CyrusAlexanderBarrett-Hammer/Programmable-furnace/Quick notes.rtf

This system has an Arduino as the central controll unit, and could, in the long run, run multiple furnaces at once, but these use cases are very few.
The controller can run as a standalone, but has extended functionality when interfaced with an interface like a computer.
The controller sends a PWM signal through a wire that is directly connected to the furnace's SSR. If the furnace has a relay, it is way too old. The signal won't be able to controll it.
Each furnace is set up by the technician with individual max temperature and if it has an in-buildt failsafe security to prevent overheating, via the GUI or from Labview. The technician will be forced to set a max temperature from an external device before the system starts.
The nominal temperature of any components used to modify the furnace like temperature sensors also needs to be taken into account when setting the furnace's maximum temperature.
Because of delays in the furnace's temperature responsiveness, the temperature can increase quite dramatically even after it is turned off. For the Heraeus Muffel 3, this is in excess of some 70 degrees at the most if the temperature increases quickly.
The max temperature for the watchdog module or the furnace's buildt-in overtemperature protector should be set to well below the furnace's nominal temperature.
All settings meant only for the technician should be accessible only through the GUI with password protection and a clear, red notice that it's only for technicians, and from Labview's programming, made inaccessible to the end user. Preferrably, a password should protect this too, Terje might do this.
If the furnace does not have an in-buildt failsafe security, the watchdog module as part of the system, that prevents overheating by guarding temperature and furnace SSR PWM signal freeze, is used instead, and a secondary thermosensor is connected to the controller.
The Heraeus Muffel 3 has allready an over-temperature protection. Every new furnace that does not use the watchdog module needs this as well in some way or another like a bi-metal to reliably prevent overheating. Consult with the data sheet/user manual. It should be NO (Normally Open) to make it more failsafe. Alternatively, the watchdog module with max temperature shutoff and furnace SSR signal PWM check, will securely prevent overheating, under the technician's responsibility.
The watchdog module can give some security if the furnace does not have an overtemperature-protector, but then it's the technician's responsibility to ensure the system complies with all laws and regulations.
The watchdog is a separate Arduino with an SSR and any other necessary components, so it's independent from the main controller. It's on the same card though.
If the watchdog module is used, the thermosensors are continously checked controller-side to compare them and see if any of them fail, potentially showing a lower temperature than what it actually is. Example scenario: The watchdog thermosensor shows 30 degrees continuously. The other shows 900, so something is wrong.
Temperatures are communicated between the main controller system's Arduino and the watchdog's Arduino.
If no temperature has been communicated between main controller Arduino and watchdog Arduino within a time frame of five seconds, indicate lost connection and turn off the furnace.
The end user should not, under any circumstance, be able to adjust any furnace's max temperature. It is entirely the techician's responsibility to set up the controller for any furnace used.
The watchdog module knows if the PWM signal is frozen by checking if the PWM signal is frozen over one second. The, something is wrong, and the temperature in the furnace will be turned off.
If the watchdog detects either that the PWM signal is frozen or the temperature is above the furnace's set nominal, it will turn the furnace off asap.
One big limitation is the Arduino's resources like CPU and RAM. One way to potentially solve this in the future is offloading to an FPGA, allowing more to be moved from the interface to the Arduino controller.
Other ways to interface the Arduino with the furnace might be implemented later, like via USB, ethernet, etc.
Bluetooth, USB, and potentially ethernet for longer range will be used between the interface and controller. Wifi might be tricky as the university's security will make development tricky.
An ethernet extender allows for a USB connection between one device and the extender, and ethernet between extender and a second device, extending the signal range. This can be bought by the end user or technician, if ethernet is added to the system.
PID will be used for temperature controll. It is autotuned by the interface, mostly for processing resource reasons, and because it isn't done very often.
The PID (Proportional Integrational Derivative) regulation is a closed loop, meaning it gets feedback from a sensor and adjusts the temperature accordingly.
Here, the Ziegler-Nichols method is used for autotune.
Kp (proportional) is how sharp the regulating value changes. Too much can overadjust.
Kd (derivative) limits the proportional swing by a fixed value. Too much makes it sluggish!
Ki (integral) Adjusts the Kd over time to get the value change more accurate (?). Too much can overadjust.
Arduino clock can be used for a periodic connectivity ping between interface and controller, and with the watchdog module, since accuracy is not important here.
Furnace must get 230V directly from a wall outlet. Extenders and splitters may overheat.
Structs are prioritised on the Arduino since they are public and therefore keeps resource intensive things like polymorphism, encapsulation, and access controll away.
On Arduino, digits only are used instead of strings for referring to messages trabsmitted over serial where practical for resource efficiency.
A controll cable is used for relay controll, since a good signal integrity is not necessary.
I use Python 3.9 since it's somewhat up to date, makes asyncio multiprocessing easier, and is supported from Labview 2021 to 2024 Q3.
Every furnace needs to be distanced from objects as specified in it's data sheet/end user manual. For the Heraeus Muffel 3, it's (insert dimensions here).
All code is written to be as asynchronous as possible, meaning that operations shouldn't need to wait for others to complete unless that's part of the functionality. They are non-blocking.
The user will be able to run PID autotune per furnace through a sequence of different goal temperatures. Autotuning will also occur in the background during normal functionality, this can be turned on or off. The resulting values are stored on the Arduino.
There will be an option where the temperature does not exceed the target, done by increasing it slowly. A seperate PID autotune can help with finding a good speed, but if not, it will just start slow and flatten out in good time before thye target temperature is reached.
The controller will have an info screen, some component for making sound, and a watchdog module, probably a separate Arduno, that takes care of checking if the PWM signal is frozen. The alarm will be sounded accordingly and the temperature will be turned off. Buttons can be added to the controller as well in the future, so it can be controlled from there as well as from the interface.
To clean up resources and shut down gracefully, Labview will need to call a Python function every 5 seconds to show it's running. A cleanup function can also be called by the user.
If first-time serial setup fails for whatever reason, the interface refuses to move on until successful connection.
Data sent between the interface and controller as strings consists of "message type value,message value for type (these two make up the total message),optional value,optional time stamp". Parts are separated by the comma delimiters.
I found pyserial was the easiest and most robust library for serial communication, but it's still unstable, like not doing automatic serial reconnects. My communication module solves that, as well as building an easy to use and hopefully efficient protocol around controller-interface communication. I kept it asynchronous and in real-time using Python's asyncio.
The furnace might still heat up quite a lot after the set max temperature is reached and the heat is turned off. The technician needs to know this overshoot and set max temperature well below it's characteristic absolute max.

Imporvements:
The Arduino is currently only a watchdog module. Suggestions for signals for a PID controller is in the signals documentation, and a lot of the code in both Python and Arduino C++ can be reused. If the PC told the Arduino what mode (or even modes) it should be in or opposite, the same Arduino can be used for both without needing to re-upload to the Arduino. The user can decide any time.
Make the Arduino able to conroll the temperature without serial communication. The Arduino will need to run PID locally, meaning the temperature on/off commands are no longer sent over serial. PC might need to run the autotune, store the PID parameter for the given temperature, and send the respective value to the Arduino to be stored in non-volatile memory. Errors coming from the Arduino will need to be signaled from a lamp with blink/color codes, on a screen, or something else.
Make it into a box with connectors so that it can standalone controll any furnace via it's SSR.
Give it a screen with current temperature, error signaling, goal temperature, and other status, perhaps with a graph that shows temperature history.
Add buttons and possibility to set goal temperature, maybe system version, etc, and perhaps a selection menu.
Use a loudspeaker or a buzzer to signal alarms and more with audio (maybe a christmas tune on the 24th of December?)
Instead of using timestamps for commands sent from the Arduino as ecorded from the PC, record and send the timestamp from the Arduino instead, giving more accurate results. The PC will need to account for time differences, or Arduino and PC timestamps must be treated differently on both devices. An RTC clock module might be necessary for the Arduino to get accurate time readings. This imporvement probably gives little payoff for the effort.
Store the furnace signal pin and PID controller/watchdog module modes set by the user in persistent memory on the Arduino like the EPROM instead of on the user's computer. No need to pass JSON files around. Keep sending them over serial during setup and check Arduino-side if it's changed. The user will not need to specify them every time when using the GUI. Send NaN for no update.
The user can change the pin values while the Arduino is running. Only the absolute max temperature, and goal temperature in PID mode that's not implemented should be changed.
Currently, status updates and user messages are only sent to a GUI. For Labview to interface with the program, it will be necessary with a place Labview can access them too. Sending to a universally accessible storage can allow both the GUI and Labview to read them. Just make shure problems don't occur if they both access it at the same time, like by using an asynchronous queue.
The system is currently limited to MAX31856 thermosensors, but there's also furnaces use PT-100 elements.
It is detectable if the SR latch external input signal is frozen high by very quickly dropping it to low once every two seconds. If it was quickly set to high when it's meant to off in the same way, the Arduino can know if it's frozen low as well. This is probably not necessary.
Add a unit number in the serial message protocol so that not only message and value is available, but also what furnace, thermosensor etc we want.
If there's a PWM frozen high error, a thermosensor error, or a furnace overheat error, the Python program won't clear these errors when the Arduino is reset. This is because the error serial messages don't have set/clear values. Either have a timeout Python side that resets errors if they are not received within a timeframe with serial connection, or maybe easier, use set/clear values for each error and send them continously. This will cause more traffic on the serial buffer, though.

HEY. TALK TO TERJE AND BEHZAD ABOUT ALWAYS HAVING TO USE SOME OVER TEMPERATURE PROTECTION ON FURNACE ITSELF. IT COULD BE SAFER, BUT ALSO BE MORE IMPRACTICAL.
