CyrusAlexanderBarrett-Hammer/Programmable-furnace/Official documentation/Abstrakt oversikt over Arduino og Python-moduler.odt

Innledning:

Her finnes en abstrakt oversikt over objekter og biblioteker som kan være ekstra interessante, og kun de mest relevante delene. Dette kan virke mye men gjør kodingen mye enklere når man har brukt tid på å forstå det som er relevant enkeltpersonen. Se objektene i selve koden for alle parametere, med datatyper, og returverdier for Python og Arduino, og feilhåndtering i Python. Arduino har minimal feilhåndtering. Koden følger ikke nødvendigvis flytskjemaets struktur. Ikke la deg bli forvirret av likheter og ulikheter mellom kode og flytskjema.

Søkefunkjsonen ctr + F kan være ekstremt nyttig for å finne funksjoner, objekter etc i programmene. Ved å holde musen over de fleste funksjoner fra biblioteker og fra det som er innebygd i Python, får man en beskrivelse av hva de gjør.

Se “sanntidskontroll Python” i “virkemåte software side minus programflyt” i hovedokumentasjonen for beskrivelse av bakgrunnsproisesser og event loops.

# Generelt om objekter og instansiering

## Bruk av instanser:

Mange av modulene i programmene kan instansieres så mange ganger man vil, som flere kontrollere for enkelte serielle porter eller timere. Hver instans har egne operasjoner og verdier av veriabler; timer1 kan ha kommet lenger i tiden enn timer2, men har samme variabler og operasjoner. Koden kan også bli ryddigere, gjort “riktig”. I Dependency Injection sendes objekter til andre som parametere ved instansiering hvis de trenger hverandre. Ryddig. Jeg har ikke tatt med disse i beskrivelsen av disse parameterne til objektene.

I Arduino: Objekttypenavn instansiertObjektNavn; for instansiering, instansiertObjektNavn.variabel eller instansiertObjektNavn.funksjon() for Arduino. Her brukes -> i stedet for . for referanser, se kode. I Arduino bruker man :: i stedet for . Med objekter som kun kan inneholde data, som enum og namespace for å bruke funksjoner, variabler, etc fra objektet. Se kode.

I Python: Objekttype navn instansiert_objekt_navn for instansiering, instansiert_objekt_navn.variabel eller instansiert_objekt_navn.funksjon() for å bruke funksjoner, variabler, etc fra objektet.

## Å lage objekter og virkemåte:

I Python: “self” refererer til instansens egne verdier og funksjoner, uten self gjelder den for alle instanser av objektet. Alle funksjoner definert i et objekt trenger self som første parameter, selv om man ikke skal oppgi den ved funksjonskall, det går automatisk i Python.

Alle spesifikke instansverdier av et objekt i Python og alt som skal gjøres i instansieringsøyeblikket, er i en __init__-funksjon. Den kjennetegner et instansierbart objekt. Parametere til objektet ved instansiering sendes hit til registrering.

I Arduino: Constructors er omtrent ekvivalenten av __init__, og kjennetegnes ved at de har samme navn som objektet de er i. Trenger man bare én instans av en klasse bruker jeg singletons, som selvinstansierer. Se Arduino-koden.

# Biblioteker brukt

Arduino: Bruker bibliotekene String.h for strengmanipulering og Adafruit_MAX31856 for thermosensor.

Python: Bruker datetime (tid og dato), asyncio og threading (sanntidskontroll og bakgrunnsprosesser), serial (seriell kommunikasjon), og tkinter (brukergrensesnitt).

# Objekter

## Arduino

### Timer:

Tar seg av stoppeklokker og timeouts i millisekunder, tiden starter ved instansiering.

Parametere ved instansiering: durationMs, startTimedOut.

Funksjoner: resetTimer, getElapsedTimeS, getElapsedTimeMs, timedOut.

### OvenOverheatWatchdog:

Sjekker overoppheting av lasten (furnace).

Parametere ved initialisering: Lasten sin makstemperatur.

Funksjoner:

check_overheat: Tar en foreløpig målt temperatur og status for temperatursensoralarm (default False) som parametere. Setter overopphetet-status ved overoppheting og ingen temperatursensorlarm.

### SrLatchFrozenWatchdog:

Sjekker om en SR-vippe har holdt seg høy over tolerert tid.

Parametere ved initialisering:

srLatchLowDurationMs: Toleransetid (SR er lav når PWM er høy)

srLatchResetPin og srLatchOutputPin: Pinnenumre for tilsvarende. Settes til OUTPUT ved initialisering.

Funksjoner: checkSrLatachFrozen, som setter watchdogens status til SR vippe låst hvis den holdt seg lav innen toleransetid.

### Max31856Sensor:

Tar konfigurering, temperaturmåling og gjenoppretting av en Max31856 thermosensor.

Parametere ved initialisering:

maxCS: Chip Select-pinnen for sensoren). Kun CS-pinnen er forskjellig for tilkoblede SPI-enheter, som sensoren.

tcType: Thermopartype koblet til sensoren (K, J, etc).

Funksjoner: readTemperature returnerer foreløpig sist målt temperatur. Ved bekreftet feil etter gjenopprettingsforsøk returneres 2023 (Labview- standard), og setter boolsk sensor error.

### Oven:

Tar ovndata og operasjon.

Parametere ved initialisering: ovenControllPin (egentlig utgangspinnen til SSR U7, settes til OUTPUT ved initialisering), og absoluteMaxTemp.

Funksjoner: turnOvenControllPinOn og TurnOvenControllPinOff. Variabel for ovnens temperatur settes utenfra.

### Messages:

Instansieres ikke. Inneholder definisjoner for meldingskategori-og-kommando. Nye meldinger lages her (og i messagePointers-listen i samme objekt).

### MessageTimeouts:

Instansieres ikke. Inneholder timer-objekter for minimum timeout mellom sending (trengs kun for periodiske meldinger).

### SerialConnectionManager:

Singleton. Setter opp og holder styr på seriell kontakt Arduino-side. Har Variabelen serialConnection.

Metoder: begin, setter opp seriell med parameteret baudRate (default 9600).

### StringMessageHandler:

Singleton. Brukes av SerialMessageHandler til koding og dekoding av serielle meldinger. Meldingsprotokollen kan endres her ved behov (godt dokumentert).

### SerialMessageHandler:

Singleton. Håndterer sending og mottakelse av meldinger til og fra PC.

Funksjoner:

passMessage: Bygger og sender en melding til PC fra parameterne message (av type Messages), value (float, default ingenting), og timestamp (string, default ingenting, format “dag/månede/år time:minutt:sekund“). Protokollendringer krever justering av parametere.

getMessage: Gir en ParsedMessageStruct fra en melding, hvis mottatt.

### SerialHandshakeHandler:

Singleton. Alt relatert til handshake.

Funksjoner: handleHandshake: Tar parameteret message, setter SerialConnectionManager sin serialConnection til true ved mottatt ping fra PC, men til false hvis ikke mottatt innen 15 sekunder.

### ParsedMessageStruct:

Instaniseres ikke. En container for Message, value, og timestamp for motatte meldinger. Komponenter må endres ved protokollendringer.

## Python

### Lavnivå

#### TimeManager:

Instansieres ikke. Håndterer timere, og datetime-konvertering med “dag/månede/år timer:minutt:sekund”.

Funksjoner: string_to_datetime og datetime_to_string for konvertering av datetime dato/tid-objekter. Tar streng og datetime-parametere, respektivt.

#### Timer (sub-objekt av TimeManager):

Instansieres med duration_ms, tiden starter da. Stoppeklokke med timeouts i millisekunder.

Funksjoner: get_elapsed_time_ms, get_elapsed_time_s timed_out, og reset_timer.

#### StringMessageHandler:

Instansieres ikke. Koder og dekoder serielle meldinger, som hos Arduino. Meldingsprotokollendringer krever endringer her. Bruker messages for meldingsdefinisjoner, se koden. Lag nye meldinger her. Instansierer sub-klassen FullMessage, en kontainer for melding (string), verdi (float), og timestamp (“string i format “dag/månede/år timer:minutt:sekund”). FullMessage instansieres utenfra ved dekoding.

#### SerialConnectionManager:

Instansieres kun av SerialManager. Tar seg av seriell kontakt. Har variabelen serial_loss, og oppdaterer brukergrensesnittet (GUI) via gui_queue.

Parametere ved instansiering: port_name (COM8, COM12 etc), baudrate (default 9600), og timeout for seriell avlesning (default 2 sekunder).

Funksjoner: setup_com (kjøres i bakgrunnen av kallende funksjon), clean_connection (for com_porten), get_connection_info

set_port_name: Brukes ved fysisk bytte av COM-port, setup_com må rekjøres via reulterende feilhåndtering.

#### SerialMessageHandler:

Instansieres kun av SerialManager, og tar serial_reading_interval (default 0.2 sekunder). Håndterer periodisk mottak av meldinger til PC i bakgrunnen (lagres), og sending fra PC. Har message_send_timeouts (Timer-objekter).

Funksjoner:

find_message: Henter melding FullMessage fra meldingslageret. find_message_with_timeout: Liknende, returnerer dictionary med timed_out og FullMessage.

get_receieved_messages: Gir alle FullMessage i lageret.

pass_message_async: Sender en melding med parameterne melding, verdi, og timestamp (format “år/måned/dag time:minutt:sekund”).

start_serial_readings og stop_serial_readings: styrer den periodiske avlesningen via run_serial_readings.

#### SerialHandshakeHandler:

Instansieres kun av SerialManager. Gjør pinging, og brukes under testing og oppretting av seriell kontakt.

Parametere ved instansiering: ping_interval (default 5), ping_timeout (default 2), og no_ping_response_timeout (default 15).

Funksjoner:

ping_handshake: Forsøker ping med ping_timeout ventetid på svar.

run_ping_loop og stop_ping_loop: Starter og stopper periodisk testing for seriell kontakt med ping_intervall run_ping_loop, ingen ping svar innen totalt no_ping_response_timeout betyr tap av seriell kontakt.

### Høynivå

#### SerialManager:

Instansieres for hver COM-port man bruker. Gå hit for å jobbe serielt på høynivå. Samler kurert funksjonalitet fra SerialConnectionManager og SerialMessageHandler.

instanciate_manager-funksjonen:

Instansierer og gir et SerialManager-objekt(kan kalles uten allerede instansiering), så den og alt i den kan startes i bakgrunnen med run_coroutine_threadsafe. Unngår async og threading-problemer!

begin-funksjonen:

Kjøres i bakgrunnen for å instansiere ting i bakgrunnen

Instansierer SerialConnectionManager, SerialHandshakeHandler, og SerialMessageHandler. Den tar argumentene port_name, baudrate og timeout, (til SerialConnectionManager)...

...serial_readings_interval (til SerialMessageHandler)...

...og ping_interval, ping_timeout, og no_ping_response_timeout (til SerialHandshakeHandler).

Kun port_name har ingen default (ikke nødvendigvis kjent ved instansiering av SerialManager).

Kurerte funksjoner:

Fra SerialConnectionManager: setup_serial (kjører setup_com), clean_connection, get_connection_info, set_port_name.

Fra SerialMessageHandler: pass_message_async, find_message, find_message_with_timeout, get_messages (kjører get_received_messages), og get_message_timeouts.

#### FuturesBridge:

Instansieres én gang og krever en ekstern event loop for bakgrunnsprosesser som parameter. Kjører og overvåker asynkrone funskjonskall i bakgrunnen, fra forgrunnen (GUI, Labview, etc), for å unngå at forgrunnen må vente.

Funksjoner:

schedule_coroutine: Tar paramterne coro (funksjon) og method_name, og kjører coro i bakgrunnen via event loop, mens den selv blir ferdig momentant. Den lagrer “futures”-objekt for kjørt funksjon umiddelbart, med metadata, i futures_metadata. futures kan brukes til å avbryte funksjonen og se når den er ferdig, og kan lagre metadataene inkludert Exception (feil under funksjonskjøring). De kan leses i ettertid av forgrunnsprosesser. Metadata er et dictionary med blant annet method_name (gitt manuelt som funskjonsparameter, identifiserer gjeldende funksjon), done (er funksjonen ferdig?), return_data, og exception (eventuelle feil som oppstår).

poll_futures: Returnerer en liste med alle ferdige futures (de har metadata), klar til håndtering.

#### Interface:

Instansieres én gang for Arduino. Er kjernen i Python-programmet som kommuniserer med Arduino. Har Arduino alarmstatuser for thermosensor_error, watchdog_pwm_frozen, furnace_overheat, og emergency_alarm, samt furnace_temperature status.

begin-funksjonen: tar parameteret port og kjører serial_manager sin begin-funksjon og klager til kallende funksjon ved veil, som feil navnformat.

Funksjoner:

run_main: Kjøres kontinuerlig i bakgrunnen, og startes, stoppes, og overvåkes utenfra med futures-objekt. Den prøver seriell gjenoppretting via SerialManager sin setup_serial ved tap (også i bakgrunnen). Videre oppdaterer den statusvariabler ved tilsvarende mottatt melding. Er emergency_alarm aktiv (trigges ved kall av force_emergency_stop), vil force_emergency_stop sendes til force_emergency_stop til Arduino.

force_emergency_stop: Setter force_emergency_stop til aktiv.

get-funksjoner: Gir respektive statuser.

#### ProcessManager:

Kontrollpanel for høynivåobjekter i Python-koden. Instansierer høynivåobjektene (Interface, FuturesBridge, SerialManager, GUI), med parameterne og objektene de trenger. Tar use_gui ved initialisering, for start av GUI. Gjør klart til bruk av bakgrunnsprosesser. Lager event loop for kjøring av bakgrunnsprosesser. Se godt kommentert kode. Alt trigges av startup().

### Front end

#### GUI:

Grafisk brukergrensesnitt.

Begin-metoden: begin() tar objektene futures_bridge, serial_manager, og interface, og kalles når de er klare. Dette håndterer instansieringsrekkefølgen og avhengighetene via gui_queue (gui_queue opprettes i GUI, men GUI instansierer SerialManager).

Funksjoner som kjøres periodisk:

poll_gui_queue: Leser meldinger fra gui_queue og oppdaterer serial status og brukermelding-displayer tilsvarende.

poll_bridge: Ser etter futures-objektene til fullførte funksjoner kjørt via FuturesBridge sin schedule_coroutine, via poll_futures-funksjonen i samme objekt. Håndterer basert på method_name , inkludert eventuelle feil under kjøring. Begge er lagret i metadataene.

Action_loop: Oppdaterer med jevne mellomrom GUI-sjekkbokser for emergency_alarm, furnace_overheat, watchdog_pwm_frozen, thermosensor_error og furnace_temperature, verdier hentes fra Interface. Annet kan gjøres her også.

Håndtereringsfunksjoner:

Ingen er laget enda.

Knapper:

“begin” som kjører on_start_setup: Starter Interface.begin med COM-port fra brukerinput og kjører Interface sin main-funksjon via FuturesBridge. Oppdaterer GUI sine brukermeldinger ved feilmelding, som ugyldig COM-port-navn. Interface sin main kjøres akkurat herfra for at den skal kunne brukes med poll_futures-mekanismen.

“change COM port” som kjører on_rename_COM: Setter ny COM-port til brukerinput. Oppdaterer GUI sine brukermeldinger ved ugyldig COM-port-navn.
