CyrusAlexanderBarrett-Hammer/Programmable-furnace/interface.py

import re
import time #Mindre funksjoinalitet enn datetime, men time.monotonic er veldig robust.
from datetime import datetime
from collections import namedtuple
import asyncio
import serial
import serial.tools.list_ports
import threading
import queue

import tkinter as tk
from tkinter import ttk

from dataclasses import dataclass
from typing import Any, Optional


class NoPingResponseTimeoutError(Exception):
    "Raised when the device haven't given a ping response for the set amount of time"
    pass

class PortNotInitializedError(Exception):
    """Raised when trying to use an unitialized serial port."""
    pass

class InvalidTimestampTypeError(Exception):
    """Raised when a datetime timestamp is expected, but got something else."""
    pass

class ErrorTools:
    @staticmethod
    def extract_error_message(e):
        parts = []
        s = str(e)
        if s:
            parts.append(s)
        if not parts and e.args:
            parts.extend(str(arg) for arg in e.args if arg)
        if hasattr(e, '__cause__') and e.__cause__:
            # Note: call the static method via the class name
            parts.append(ErrorTools.extract_error_message(e.__cause__))
        if not parts:
            parts.append(repr(e))
        return " ".join(parts)

    @staticmethod
    def check_nested_error(e, exception):
        exception_string = exception.__name__
        error_str = ErrorTools.extract_error_message(e)
        return exception_string in error_str

class TimeManager:
    time_string_format = "%d/%m/%Y %H:%M:%S"

    class Timer:
        def __init__(self, duration_ms = None):
            if not isinstance(duration_ms, (int, None)):
                raise TypeError(f"duration is of type {type(duration_ms).__name__}, expected int") #Level 1

            self.duration_ms = duration_ms
            self.last_blocking_timer_call = time.monotonic()

            self.start_time = 0
            
            self.start_time = time.monotonic()

        def get_elapsed_time_ms(self):
            elapsed_time = self.get_elapsed_time_s()
            return elapsed_time * 1000

        def get_elapsed_time_s(self):
            current_time = time.monotonic()
            elapsed_time = current_time - self.start_time #Subtracting two datetime objects gives a datetime.deltatime object
            return elapsed_time
        def timed_out(self):
            return self.get_elapsed_time_ms() >= self.duration_ms
        def reset_timer(self):
            self.start_time = time.monotonic()
            
    
    @classmethod
    def string_to_datetime(cls, datetime_string):
        """
        Convert a date string into a datetime object using the provided format.

        :param date_string: The date string to be converted, e.g. "12/31/2024 23:59:59".
        :param time_string_format: The datetime format, default "%m/%d/%Y %H:%M:%S".
        :return: A datetime object if parsing is successful.
        :raises ValueError: If the date string does not match the format.
        """
        try:
            return datetime.strptime(datetime_string, cls.time_string_format)
        except ValueError:
            raise ValueError

    @classmethod
    def datetime_to_string(cls, datetime):
        """
        Convert a datetime object into a formatted string using the provided format.

        :param dt_obj: The datetime object to be converted.
        :param time_string_format: The datetime format, default "%m/%d/%Y %H:%M:%S".
        :return: A date string in the specified format.
        :raises ValueError: If the format string is invalid.
        """
        try:
            return datetime.strftime(cls.time_string_format)
        except ValueError:
            raise ValueError

class StringMessageHandler:

    MessageStruct = namedtuple('MessageStruct', ['category', 'message']) #Categories, enforce, structure! See "signals" in the "official documentation" file.

    #If the serial part of this system was a library, these should really be set by Serial Manager as a class attribute
    messages = {
        "ping_pc_arduino": MessageStruct("1", "1"),
        "ping_arduino_pc": MessageStruct("1", "2"),
        "temperature_reading": MessageStruct("2", "1"),
        "force_emergency_stop": MessageStruct("4", "0"),
        "emergency_alarm": MessageStruct("9", "0"),
        "thermosensor_error": MessageStruct("9", "1"),
        "watchog_pwm_frozen": MessageStruct("9", "2"),
        "furnace_overheat": MessageStruct("9", "3"),
    }

    valid_messages = ", ".join(messages.keys())

    expected_parts = 4
    message_part_separator = ","

    @dataclass
    class FullMessage:
        message_key: str
        value: Optional[Any] = None
        timestamp: Optional[datetime] = None
        message_valid: bool = False

    @classmethod
    def build_message(cls, full_message):
        # Build the full message string to be sent
        outgoing_parts = []

        # Construct the full message string
        message = full_message.message_key #No need
        outgoing_parts.append(message)
        outgoing_parts.append(full_message.value if full_message.value is not None else "NaN")
        outgoing_parts.append(full_message.timestamp if full_message.timestamp is not None else "NaN")

        # Join all parts with the part separator character
        outgoing = cls.message_part_separator.join(outgoing_parts)

        return outgoing

    @classmethod
    def parse_message(cls, message_str):
        message_valid = False

        # Split the message string into parts
        incoming_parts = message_str.split(cls.message_part_separator)

        # Check if the message has the correct number of parts
        if len(incoming_parts) != cls.expected_parts:
            print(f"Message '{message_str}' has an unexpected number of parts. Expected {cls.expected_parts}.")
        else:
            message_valid = True

        if message_valid:
            parsed = {
                'message_instruction': incoming_parts[0] + cls.message_part_separator + incoming_parts[1],
                'value': incoming_parts[2],
                'timestamp': incoming_parts[3],
                'message_valid': True
            }
        else:
            parsed = {
                'message_instruction': None,
                'value': None,
                'timestamp': None,
                'message_valid': False
            }

        return parsed

    @classmethod
    def encode_message(cls, full_message):
        # Get the message type value
        message_value = cls.messages[full_message.message_key]

        string_message_key = cls.message_part_separator.join([
            str(message_value.category),
            str(message_value.message)
        ])
        full_message.message_key = string_message_key

        # Add value if required
        if full_message.value is not None:
            full_message.value = str(full_message.value)
        else:
            full_message.value = "NaN"

        # Add the timestamp if required
        if full_message.timestamp is not None:
            try:
                formatted_timestamp = TimeManager.datetime_to_string(full_message.timestamp) #Level 2
            except ValueError:
                print(f"Format is incorrect, expected {TimeManager.time_string_format}. Big letters can include a zero as first digit, like 05, small letters cannot.")
                raise
            full_message.timestamp = str(formatted_timestamp)
        else:
            full_message.timestamp = "NaN"
        return full_message

    @classmethod
    def decode_message(cls, parsed):
        # Try to find the message key based on category and message
        message_valid = False
        message_key = None
        value = None
        timestamp = None

        if parsed["message_valid"]:
            for key, msg_val in cls.messages.items():
                category, message = parsed['message_instruction'].split(cls.message_part_separator)
                if msg_val.category == category and msg_val.message == message:
                    message_key = key
                    break
            if message_key is None:
                print(f"Unknown message type for category '{parsed['message_instruction']}'. Setting to None, the message to invalid, and moving on.")
            else:
                message_valid = True

            value = parsed["value"] if parsed["value"] != "NaN" else None
            timestamp = parsed["timestamp"] if parsed["timestamp"] != "NaN" else None

            if timestamp is not None:
                try:
                    converted_datetime = TimeManager.string_to_datetime(timestamp)
                except ValueError:
                    print(f"Format is incorrect, expected {cls.time_manager.time_string_format}. Big letters can include a zero as first digit, like 05, small letters cannot. Setting to None, the message to invalid, and moving on.")
                    converted_datetime = None
                    message_valid = False
                timestamp = converted_datetime

        return cls.FullMessage(message_key, value, timestamp, message_valid)


class SerialConnectionManager:

    port_initialization_time = 1.6

    def __init__(self, port_name, baud_rate=9600, timeout=2, gui_queue=None):
        try:
            self.set_port_name(port_name)
        except:
            raise

        if not isinstance(baud_rate, int):
            print(f"Baudrate {baud_rate} not an integer")
            raise TypeError(f"Baudrate {baud_rate} not an integer")
        
        elif not isinstance(timeout, (int, float)):
            print(f"Timeout {timeout} not an integer or float")
            raise TypeError(f"Timeout {timeout} not an integer or float")

        self.serial_handshake_handler = None #Needs instanciation of SerialHandshakeHandler at a higher level before being set due to circular dependencies
        self.serial_message_handler = None #Same, but for SerialMessageHandler
        
        self.port_name = port_name # Store the COM port name (like COM18)
        self.baud_rate = baud_rate # Store the baud rate
        self.timeout = timeout # Store the timeout

        self.serial_port = None
        self.serial_loss = True

        self.all_serial_ports = []

        self.recent_port_name = self.port_name #Compared with self.port_name to check port name change
        self.connect_in_progress = False

        self.asyncio_lock = asyncio.Lock()
        self.threading_lock = threading.Lock()
        self.gui_queue = gui_queue # Optional: For GUI updates

    def begin(self, serial_message_handler, serial_handshake_handler):
        self.serial_message_handler = serial_message_handler
        self.serial_handshake_handler = serial_handshake_handler

    async def setup_COM(self):
        # Setup serial connection
        if self.connect_in_progress or not self.serial_loss:
            return # Avoid multiple reconnection attempts at once. Also, avoids deadlocks between this method and pass_message.
        self.connect_in_progress = True

        # Avoid ping confusion, can't ping while setting up the port
        self.serial_handshake_handler.stop_ping_loop()
        #Reading serial messsage are done from here, for local error handling and avoiding ping_task from stealing the ping response message
        self.serial_message_handler.stop_serial_readings()

        self.gui_queue.put({"serial_status": "connecting"})

        connection_success = False
        while not connection_success:
            if not self.port_name == self.recent_port_name:
                self.clean_connection()
                self.recent_port_name = self.port_name

            try:
                if self.serial_port is None:
                    await self.initialize_port()
                #Clear old ping responses in both buffer and storage, we want relevants
                print("ABOUT TO RUN FROM SETUP_COM")
                await self.serial_message_handler.store_all_messages_async()
                self.serial_message_handler.find_message("ping_arduino_pc", purge = True)
                #Attempt connection
                connection_success = await self.attempt_connection()
            except Exception as e:
                self.update_for_serial_error(e)
                raise
            #No response? Wrong! Do it again! (No dark sarcasm in the classroom)
        
        self.serial_loss = False #Got this far? Serial port is confirmed.
        self.gui_queue.put({"serial_error": "running smoothy"})
        self.gui_queue.put({"serial_status": "serial connection established"})
        
        #Success, start or resume periodic serial processes
        self.serial_message_handler.start_serial_readings()
        self.serial_handshake_handler.start_ping_loop()
        self.connect_in_progress = False

    async def attempt_connection(self):
        try:
            handshake_result = await self.serial_handshake_handler.ping_handshake()
        except:
            raise
        if handshake_result:
            print(f"Handshake completed on port {self.serial_port.name} at {self.serial_port.baudrate} baud.")
            return True
        else:
            return False

    async def initialize_port(self):
        loop = asyncio.get_running_loop()

        try:
            # Open serial port in executor to prevent blocking
            async with self.asyncio_lock:
                self.serial_port = await loop.run_in_executor(None, lambda: serial.Serial(self.port_name, self.baud_rate, timeout=self.timeout))
        except (serial.SerialException) as e:
            print(f"Error setting up port: {e}")
            if ErrorTools.check_nested_error(e, FileNotFoundError):
                raise FileNotFoundError #Level 1
            elif ErrorTools.check_nested_error(e, PermissionError):
                raise PermissionError #Level 1

        await asyncio.sleep(self.port_initialization_time) # Wait for the serial port to initialize

    async def clean_connection(self):
        try:
            await self.close_connection()
        except:
            print(f"Serial port is not initialized.") #Then there's no problem! No need to raise.
        self.serial_port = None

    async def close_connection(self):
        with self.threading_lock:
            if not self.serial_port:
                print(f"Serial port is not initialized.")
                raise PortNotInitializedError()
    
            if not self.serial_port.is_open:
                print(f"Serial connection on {self.serial_port} is already closed.")
                return #This can pass silently
    
            try:
                async with self.asyncio_lock:
                # Close serial port in executor to prevent blocking
                    loop = asyncio.get_running_loop()
                    await loop.run_in_executor(None, self.serial_port.close)
                    print(f"Serial connection on {self.serial_port.name} closed.")
            except (serial.SerialException) as e:
                print(f"Serial exception when attempting to close port {self.serial_port.name}.")
                raise e

    def update_for_serial_error(self, e):
        self.serial_loss = True
        if not self.gui_queue is None:
            if ErrorTools.check_nested_error(e, FileNotFoundError):
                self.gui_queue.put({"serial_error": "Serial COM port not found. Connect device, or set correct COM port as seen in device manager"})
            elif ErrorTools.check_nested_error(e, PermissionError):
                self.gui_queue.put({"serial_error": "Serial COM port allready in use or denied. Verify that nothing else is using the COM port, or set correct COM port as seen in device manager"})
            elif isinstance(e, NoPingResponseTimeoutError):
                self.gui_queue.put({"serial_error": "No communication with Arduino. Check that the device is connected to the set COM port as seen in device manager, and verify it's working."})
            self.gui_queue.put({"serial_status": "serial connection lost"})

    def get_connection_info(self):
        with self.threading_lock:
            return {
                'serial_loss': self.serial_loss,
                'port_name': self.port_name,
                'baud_rate': self.baud_rate,
                'timeout': self.timeout,
                'port_open': True if not self.serial_port is None and self.serial_port.is_open else False
            }

    def set_port_name(self, port_name):
        with self.threading_lock:
            if not isinstance(port_name, (str, int)):
                raise TypeError(f"port_name must be a string or int, got {type(port_name).__name__}")

            elif isinstance(port_name, int):
                if port_name < 0:
                    raise ValueError(f"port_name cannot be negative, got {port_name}")
                self.port_name = "COM" + str(port_name)
            elif isinstance(port_name, str):
                if not re.fullmatch(r"(COM\d+|\d+)", port_name):
                    raise ValueError(f"port_name must be 'COM' followed by a number (e.g., COM18), or just a number (e.g., 18). Got {port_name}")
                elif port_name.isdigit():
                    self.self.port_name = "COM" + str(port_name)


class SerialMessageHandler:

    def __init__(self, serial_connection_manager, serial_readings_interval = 0.2):
        
        if not isinstance(serial_readings_interval, (int, float)):
            raise TypeError(f"serial_readings_interval must be an int or float, got {type(serial_readings_interval).__name__}")

        self.serial_connection_manager = serial_connection_manager

        self.serial_readings_interval = serial_readings_interval

        self.received_message_buffer = [] #Using array, because event queues don't allow checking without removing from it. Simpler and more robust.

        self.serial_readings_task = None

        self.asyncio_lock = asyncio.Lock()
        self.threading_lock = threading.Lock()
        
        self.message_send_timeouts = {
            "ping_pc_arduino": TimeManager.Timer(5000),
            "force_emergency_stop": TimeManager.Timer(1000)
        }
    
    def get_receieved_messages(self):
        with self.threading_lock:
            return self.received_message_buffer
    
    def get_message_timeouts(self):
        with self.threading_lock:
            return self.message_send_timeouts

    def find_message(self, message, purge = False):
        with self.threading_lock:
            if message not in StringMessageHandler.messages.keys():
                raise KeyError(f"Message type '{message}' does not exist. Valid messages are: {StringMessageHandler.valid_messages}")
            for i in self.received_message_buffer:
                if i.message_key == message:
                    self.received_message_buffer.pop(self.received_message_buffer.index(i))
                    if not purge: #If purge, keep tracking down and purging messages without returning
                        return i
        return None
    
    def find_message_with_timeout(self, timer, message):
        status = {
            "timed_out": False,
            "message": None
        }

        found_message = self.find_message(message)

        if not isinstance is None:
            status["timed_out"] = False
            status["message"] = found_message
        if timer.timed_out():
            status["timed_out"] = True
        return status

    async def find_message_with_blocking_timeout(self, message, timeout, pull=False):
        """
        Finds a message with a blocking timeout.

        Parameters:
            message: The message to find.
            timeout: The maximum time to search for the message (in seconds).
            pull: If True, stores all messages from the buffer before searching.

        Returns:
            The found message, or None if not found within the timeout.
        """
        timer = TimeManager.Timer(timeout * 1000)
        while not timer.timed_out():
            if pull:
                try:
                    print("ABOUT TO RUN FROM FIND_MESSAGE_WITH_BLOCKING_TIMEOUT")
                    await self.store_all_messages_async()
                except (FileNotFoundError, PermissionError):
                    raise

            found_message = self.find_message(message)
            if found_message is not None:
                return found_message

        return None
    
    async def store_all_messages_async(self):
        print("STARTED")
        try:
            while self.serial_connection_manager.serial_port.in_waiting:
                message = await self.get_message_async()
                if message.message_valid:
                    self.received_message_buffer.append(message)
            print("STOPPED SUCCESSFULLY")
        except Exception as e:
            print(f"STOPPED WITH {e}")
            raise

    async def pass_message_async(self, message, value=None, timestamp=None):
        if not isinstance(message, str):
                raise TypeError("Message is not a string") #Level 1

        if message not in StringMessageHandler.messages.keys():
            raise KeyError(f"Message type '{message}' does not exist. Valid messages are: {StringMessageHandler.valid_messages}") #Level 1

        if not isinstance(timestamp, (datetime, type(None))):
            raise InvalidTimestampTypeError(f"Timestamp is of type {type(timestamp).__name__}; expected datetime or None") #Level 1

        full_message = StringMessageHandler.FullMessage(message, value, timestamp)
        encoded_message = StringMessageHandler.encode_message(full_message)
        buildt_message = StringMessageHandler.build_message(encoded_message)

        try:
            await self.send_message_async(buildt_message)
        except (FileNotFoundError, PermissionError) as e:
            print(f"Error sending message: {e}")
            raise

    async def get_message_async(self):
        try:
            message_str = await self.receive_message_async()
        except Exception as e:
            print(f"Error receiving message: {e}")
            raise
        parsed = StringMessageHandler.parse_message(message_str)
        decoded_message = StringMessageHandler.decode_message(parsed)
        return decoded_message

    async def send_message_async(self, message):
        loop = asyncio.get_running_loop()

        async with self.asyncio_lock:
            try:
                await loop.run_in_executor(None, lambda: self.serial_connection_manager.serial_port.write((message + '\n').encode('utf-8')))  #Lambda required for arguments
            except (serial.SerialException, Exception) as e:
                print(f"Message not sent: {e}")
                if ErrorTools.check_nested_error(e, FileNotFoundError):
                    self.serial_connection_manager.update_for_serial_error(FileNotFoundError)
                    raise FileNotFoundError #Level 1
                elif ErrorTools.check_nested_error(e, PermissionError):
                    self.serial_connection_manager.update_for_serial_error(PermissionError)
                    raise PermissionError #Level 1

        print(f"Sent: {message.encode('utf-8')}")

    async def receive_message_async(self):
        loop = asyncio.get_running_loop()

        message_decoded = ""

        async with self.asyncio_lock:
            try:
                message = await loop.run_in_executor(None, self.serial_connection_manager.serial_port.readline)
                message_decoded = message.decode('utf-8').strip()
            except (serial.SerialException, Exception) as e:
                print(f"Message not sent: {e}")
                if ErrorTools.check_nested_error(e, FileNotFoundError):
                    self.serial_connection_manager.update_for_serial_error(FileNotFoundError)
                    raise FileNotFoundError #Level 1
                elif ErrorTools.check_nested_error(e, PermissionError):
                    self.serial_connection_manager.update_for_serial_error(PermissionError)
                    raise PermissionError #Level 1

        print(f"Received: {message_decoded}")
        return message_decoded
    
    def start_serial_readings(self, interval=None):
        if interval is None:
            interval = self.serial_readings_interval
        self.serial_readings_task = asyncio.create_task(self.run_serial_readings(interval))

    def stop_serial_readings(self):
        # Cancel the serial reading loop task if it's running
        if self.serial_readings_task:
            self.serial_readings_task.cancel()

    async def run_serial_readings(self, interval):
        try:
            while True:
                print("ABOUT TO RUN FROM RUN_SERIAL_READINGS")
                await self.store_all_messages_async()
                await asyncio.sleep(interval)
        except (FileNotFoundError, PermissionError) as e:
            print(f"Serial readings failed: {e}") #No reraise is intentional
        except asyncio.CancelledError:
            print("Serial reading loop cancelled.")

class SerialHandshakeHandler:

    def __init__(self, serial_connection_manager, serial_message_handler, ping_interval = 5, ping_timeout = 2, no_ping_response_timeout = 15):
        if not isinstance(ping_interval, (int, float)):
            raise TypeError(f"ping_interval must be float or int, got {type(ping_interval)}")
        elif not isinstance(ping_timeout, (int, float)):
            raise TypeError(f"ping_timeout must be float or int, got {type(ping_timeout)}")
        elif not isinstance(no_ping_response_timeout, (int, float)):
            raise TypeError(f"no_ping_response_timeout must be float or int, got {type(no_ping_response_timeout)}")
        
        self.serial_message_handler = serial_message_handler
        self.serial_connection_manager = serial_connection_manager

        self.ping_interval= ping_interval
        self.ping_timeout = ping_timeout
        self.no_ping_response_timeout = no_ping_response_timeout

        self.ping_task = None

        self.asyncio_lock = asyncio.Lock()
        self.threading_lock = threading.Lock()

    async def ping_handshake(self):
        # Perform the handshake asynchronously
        try:
            await self.serial_message_handler.pass_message_async("ping_pc_arduino")
            print("Sent handshake ping.")
        except Exception as e:
            print(f"Error during ping handshake: {e}")
            raise
        
        try:
            response = await self.serial_message_handler.find_message_with_blocking_timeout("ping_arduino_pc", self.ping_timeout, pull = True)
        except Exception as e:
            print(f"Error during ping handshake: {e}")
            raise
        if not response is None: #Found the response
            print("Received valid handshake response.")
            return True
        else:
            print("Did not receive valid handshake response.")
            return False

    async def run_ping_loop(self, interval, no_response_timeout):
        timer = TimeManager.Timer(no_response_timeout * 1000)

        # Ping loop to perform handshake every `interval` seconds
        try:
            while True:
                success = await self.ping_handshake()
                if success:
                    timer.reset_timer()
                elif timer.timed_out:
                    raise NoPingResponseTimeoutError
                await asyncio.sleep(interval)
        except NoPingResponseTimeoutError as e:
            self.serial_connection_manager.update_for_serial_error(e)
            print(f"Arduino didn't respond to ping for {no_response_timeout} seconds.") #No reraise is intentional
        except (FileNotFoundError, PermissionError) as e:
            print(f"Ping failed: {e}") #Same
        except asyncio.CancelledError:
            print("Ping loop cancelled.") #Same

    def start_ping_loop(self, interval=None, no_response_timeout = None):
        if interval is None:
            interval = self.ping_interval
        if no_response_timeout is None:
            no_response_timeout = self.no_ping_response_timeout
        self.ping_task = asyncio.create_task(self.run_ping_loop(interval, no_response_timeout))

    def stop_ping_loop(self):
        # Cancel the ping loop task if it's running
        if self.ping_task:
            self.ping_task.cancel()


class SerialManager():
    """
    Central manager for all serial communication functionalities.
    Encapsulates connection management, message handling, and handshake processes.
    """

    def __init__(self, gui_queue = None):
        self.gui_queue = gui_queue
        
        self.port_name = ""
        self.baud_rate = 0
        self.timeout = 0
        self.serial_readings_interval = 0
        self.ping_interval = 0

        self.serial_connection_manager = None
        self.serial_message_handler = None
        self.serial_handshake_handler = None

        self.begin_run = False #Used to check if this classes's instantiatable managers and handlers' methods are ready to be used

        self.messages = {}
        self.valid_messages = ""


    #Non-blocking, but async so it can be run in the background event loop, from the foreground, with run_coroutine_threadsafe
    async def instanciate_manager(gui_queue = None):
        return SerialManager(gui_queue)

    #this method misses and needs value verifications. #Non-blocking, but async so it can be run in the background event loop, from the foreground, with run_coroutine_threadsafe
    async def begin(self, port_name, baud_rate=9600, serial_reading_timeout=2, serial_readings_interval = 0.2, ping_interval = 5, ping_timeout = 2, no_ping_response_timeout = 15):
        self.port_name = port_name
        self.baud_rate = baud_rate
        self.timeout = serial_reading_timeout
        self.serial_readings_interval = serial_readings_interval
        self.ping_interval = ping_interval
        self.ping_timeout = ping_timeout
        self.no_ping_respone_timeout = no_ping_response_timeout

        try:
            #Input from GUI or unimplemented Labview starts serial processes only when values like the COM port is known.
            #Instantiate managers and handlers

            #Where's StringMessageHandler? It does not need instanciation.
            self.serial_connection_manager = SerialConnectionManager(self.port_name, self.baud_rate, self.timeout, gui_queue=self.gui_queue)
            self.serial_message_handler = SerialMessageHandler(self.serial_connection_manager)
            
            self.serial_handshake_handler = SerialHandshakeHandler(
                self.serial_connection_manager,
                self.serial_message_handler,
                self.ping_interval, self.ping_timeout,
                self.no_ping_respone_timeout,
            )
        except (ValueError, TypeError, KeyError): #This is an entry point, I know, but copy-pasting 50 lines of code is avoided.
            raise

        self.serial_connection_manager.begin(self.serial_message_handler, self.serial_handshake_handler)
        
        #If the serial part of this system was a library, these should really be set in serial manager as a class attribute
        self.messages = StringMessageHandler.messages
        self.valid_messages = StringMessageHandler.valid_messages
        
        self.begin_run = True

    async def setup_serial(self):
        try:
            await self.serial_connection_manager.setup_COM()
        except asyncio.CancelledError:
            await self.clean_connection()
            print("Setup cancelled.")
        except Exception as e:
            print("Setup failed.")
            raise

    async def pass_message_async(self, message, value=None, timestamp=None):
        if self.get_connection_info["serial_loss"]:
            raise ValueError("No serial connection, can't send message")

        if not isinstance(message, str):
                raise TypeError("Message is not a string")
        if message not in self.messages.keys():
            raise KeyError(f"Message type '{message}' does not exist. Valid messages are: {self.valid_messages}") #Level 1
        if not isinstance(timestamp, (datetime, type(None))):
            raise InvalidTimestampTypeError(f"Timestamp is of type {type(timestamp).__name__}; expected datetime or None") #Level 1

        try:
            await self.serial_message_handler.pass_message_async(message, value, timestamp)
        except (FileNotFoundError, PermissionError) as e:
            print(f"Error sending message: {e}")
            raise
        
    def find_message(self, message):
        if not isinstance(message, str):
            raise TypeError(f"message needs to be of type str, got {type(message).__name__}.")
        if message not in self.messages.keys():
            raise KeyError(f"Message type '{message}' does not exist. Valid messages are: {self.valid_messages}")
        return self.serial_message_handler.find_message(message)

    def find_message_with_timeout(self, timer, message):
        if not isinstance(timer, TimeManager.Timer):
            raise TypeError(f"timer needs to be of type TimeManager.Timer, got {type(timer).__name__}.")
        if not isinstance(message, str):
            raise TypeError(f"message needs to be of type str, got {type(message).__name__}.")
        return self.serial_message_handler.find_message_with_timeout(timer, message)

    def set_port_name(self, port_name):
        try:
            self.serial_connection_manager.set_port_name(port_name)
        except (ValueError, TypeError):
            raise

    def get_messages(self):
        return self.serial_message_handler.get_receieved_messages()

    def get_connection_info(self):
        return self.serial_connection_manager.get_connection_info()
    
    def get_message_timeouts(self):
        return self.serial_message_handler.get_message_timeouts()

    async def clean_connection(self):
        await self.serial_connection_manager.clean_connection()

    async def shutdown(self):
        """
        Gracefully shutdown the asyncio event loop and close serial connections.
        """
        self.serial_handshake_handler.stop_ping_loop()
        self.serial_message_handler.stop_serial_readings()
        # Schedule the clean_connection coroutine in the event loop
        asyncio.run_coroutine_threadsafe(
            await self.serial_connection_manager.clean_connection(),
            self.loop
        )

class FuturesBridge:
    """
    Used when running coroutines from a different event loop.
    Data about each method call (method name, arguments, return data, exception) are stored and can externally be handled when ready, if any.
    Has mechanisms to only allow running a coroutine from one place at a time, if wanted. Simple reject if yes.
    """

    def __init__(self, event_loop):
        self.loop = event_loop
        self.futures_metadata = {} #{Future{"method_name", "params", "done", "return_data", "exception"}}In here will be one or more dictionaries with method call data.
        self.asyncio_lock = threading.Lock()

    def schedule_coroutine(self, coro, method_name, allow_parallel = False, **params):
        """
        Schedules the passed coroutine coro, and stores it's given and eventual metadata in self.futures_data
        :param corro: The method (can have arguments) to be run in different event loop
        :param method_name: The name of the run method, it's not robust to get the method name dynamically
        :param allow_parallel: Let two methods of the same name run at the same time?
        :param params: Any arguments sent to the called method that should be in the metadata?
        :raises RuntimeError: If the method is allready running with allow_parallel = True
        """

        with self.asyncio_lock:
            if not allow_parallel:
                #Refuse to run if the method with given passed name is allready running
                for fut, metadata in self.futures_metadata.items():
                    if metadata["method_name"] == method_name and not fut.done():
                        raise RuntimeError(f"Method '{method_name}' is already running") #Rejection!

        fut = asyncio.run_coroutine_threadsafe(coro, self.loop) #Run the coroutine in the given event loop and get result as future object
        info = {
            "method_name": method_name,
            "params": params,
            "done": False,
            "return_data": None,
            "exception": None
        }

        with self.asyncio_lock:
            self.futures_metadata[fut] = info

    def poll_futures(self):
        """
        Gives the metatdata for any futures for completed methods in a list of dictionaries, one future per index
        The future is tested for any exceptions raised while running the coroutine, and that is stored in the metadata
        
        return: List with dictionaries, one per completed future, with their metadata method_name, params, return_data, and exception 
        """
        completed = []
        with self.asyncio_lock:
            remove = [] #Remove these futures if they are going to be put in the return list
            #Get metadata for all active futures
            for fut, metadata in self.futures_metadata.items():
                if fut.done() and not metadata["done"]:
                    metadata["done"] = True #Avoid redundant iterations

                    #Test for exceptions
                    try:
                        return_data = fut.result() #Grayed out! OK because it's just provoking an exception.
                    except Exception as e:
                        metadata["exception"] = e

                    completed.append({
                        "method_name": metadata["method_name"],
                        "params": metadata["params"],
                        "return_data": metadata["return_data"],
                        "exception": metadata["exception"]
                    })
                    remove.append(fut)

            for fut in remove:
                self.futures_metadata.pop(fut, None) #Gone, no longer needed, bye!

        return completed


class Interface:

    def __init__(self, serial_manager):

        self.serial_manager = serial_manager

        self.main_task = None
        self.setup_serial_task = None
        self.pass_message_task = None

        self.begin_run = False
        self.main_running = False

        self.force_emergency_stop_status = False

        #Arduino alarm statuses
        self.thermosensor_error = False
        self.watchdog_pwm_frozen = False
        self.furnace_overheat = False
        self.emergency_alarm = False

        self.furnace_temperature = None


    def begin(self, port):
        """
        Procedure for setting up serial, and then starting start_main method. Gets the engines running.
        """
        try:
            self.serial_manager.begin(port) #Will complain if port format is incorrect.
        except(ValueError, TypeError, KeyError):
            raise

        #Where's start_setup_serial()? It will be triggered when main() detects serial loss.
        #This is clumsy but simpler for retrying serial connection on fail.
        self.begin_run = True
    
    def get_furnace_temperature_status(self):
        return self.furnace_temperature

    def get_thermosensor_error_status(self):
        return self.thermosensor_error

    def get_watchdog_pwm_frozen_status(self):
        return self.watchdog_pwm_frozen
    
    def get_furnace_overheat_status(self):
        return self.furnace_overheat
    
    def get_emergency_alarm_status(self):
        return self.emergency_alarm
    

    def force_emergency_stop(self):
        self.force_emergency_stop_status = True


    def start_setup_serial(self):
        if not self.setup_serial_task:
            self.setup_serial_task = asyncio.create_task(self.serial_manager.setup_serial())
        
    def stop_setup_serial(self):
        # Cancel the serial reading loop task if it's running
        if self.setup_serial_task:
            self.setup_serial_task.cancel()


    async def main(self): #Run by using futures_bridge via run_coroutine_threadsafe, in the background.
        self.main_running = True
        message_timeouts = self.serial_manager.get_message_timeouts

        try:
            while True:
                connection_info = self.serial_manager.get_connection_info()
                serial_loss = connection_info["serial_loss"]
                if serial_loss:
                    #Will run while the rest of the code runs
                    if not self.setup_serial_task:
                        self.setup_serial_task = asyncio.create_task(self.serial_manager.setup_serial())
                
                furnace_temperature_result = self.serial_manager.find_message("temperature_reading")
                if not furnace_temperature_result is None:
                    self.furnace_temperature = furnace_temperature_result.value

                #The errors are only cleared Arduino-side if the Arduino is restarted. This program will need a restart too, it lackas an error clearance if no error after some time of serial communication.
                if self.serial_manager.find_message("thermosensor_error"):
                    self.thermosensor_error = True

                if self.serial_manager.find_message("watchdog_pwm_frozen"):
                    self.watchdog_pwm_frozen = True

                if self.serial_manager.find_message("furnace_overheat"):
                    self.furnace_overheat = True
                
                if self.serial_manager.find_message("emergency_alarm"):
                    self.emergency_alarm = True

                if self.force_emergency_stop_status and message_timeouts["force_emergency_stop"].timed_out():
                    asyncio.create_task(self.serial_manager.pass_message_async("force_emergency_stop"))
                    message_timeouts["force_emergency_stop"].reset_timer()
                
        except asyncio.CancelledError:
            self.main_running = False
            print("Serial reading loop cancelled. Running cleanup.")
            self.stop_setup_serial()
    
class ProcessManager:
    """
    Encapsulates overall procedures for managing processes
    """

    def __init__(self, use_gui):
        self.use_gui = use_gui

        #GUI will run in the main thread and trigger methods via futures_bridge, the rest will run in a background thread
        #Truly simultaneously running tasks is done with threads, as opposed to event loops...
        # ...They are shortcuts to allowing other processes to run in between each other, automatically switching between async methods (or coroutines) whenever possible (like in between actions or during async sleep())
        #If the GUI and the rest is run in the same thread, the GUI might lag.
        #Locks (async.Lock()) forces a process to wait for accessing places in memory until no other processes do it, avoing race conditions where the computer gets confused. Nice for single operations that take some time.
        #Using "with async.lock() means the place in memory will only be locked for as long as it's used at the moment.
        #Threads are required to use event loops, and in turn, coroutines. Tkinter GUIs have to be run in the main thread (what's usually run without multithreading), but does not require an event loop.
        #run_coroutine_threadsafe(coro, event) runs a coroutine (coro) in the given event loop (event). Whatever called run_coroutine_threadsafe continues meanwhile without waiting.
        #When a normal method calls a coroutine (ike via run_coroutine_threadsafe), any errors or return values will only be available after the coroutine finished. Meanwhile, the method allready has finished.
        #That's why the futures_bridge is there. It stores these as so-called futures, that are then accessed afterward when available.

        self.futures_bridge = None

        self.gui = None

        self.serial_manager = None
        self.interface = None

        self.gui_queue = None

        # The single event loop for all async tasks. GUI has no event loop.
        self.loop = asyncio.new_event_loop()

        # Thread that will run the above loop
        self.asyncio_thread = None

    # Boots up the system
    def startup(self):
        if self.use_gui:
            self.gui = GUI() #Instanciate GUI
            self.gui_queue = self.gui.gui_queue
        else:
            print("Starting system without GUI")
        
        #Used by any top-level class like GUI or unimplemented Labview functions to interact with coroutines
        self.futures_bridge = FuturesBridge(self.loop)

        #Instanciate async components
        self.serial_manager = asyncio.run_coroutine_threadsafe(SerialManager.instanciate_manager(gui_queue = self.gui_queue), self.loop) #gui_queue is used to send messages to the GUI from elsewhere
        self.interface = Interface(self.serial_manager)

        #Working with circular dependencies. Serial manager needed the GUI for gui_queue first.
        if self.gui:
            self.gui.begin(self.futures_bridge, self.serial_manager, self.interface)

        #Start the asyncio event loop in a separate thread. It targets run_asyncio_loop to run it in the thread.
        self.asyncio_thread = threading.Thread(target = self.run_asyncio_loop)
        self.asyncio_thread.start()

        if self.gui:
            self.gui.run()

    def run_asyncio_loop(self):
        #A new thread targets this method, so it's running there. Start the event loop self.loop in that thread.
        asyncio.set_event_loop(self.loop)
            
        #Keep the event loop running and ready for use
        self.loop.run_forever()

    #Fix and use graceful shutdown and add more shutdown detections. Shutdown is currently not implemented for all classes, but is on good way.
    def full_shutdown(self):
        self.serial_manager.shutdown()
        # Stop event loop
        if self.loop.is_running():
            self.loop.call_soon_threadsafe(self.loop.stop)
        # Join the background thread
        if self.asyncio_thread:
            self.asyncio_thread.join()
        print("Shutdown complete.")


class GUI:
    #Nothing here can be async or blocking, as it will block the GUI. Hence, FuturesBridge for sync to async bridging.

    #See comments in FuturesBridge for how the GUI works with futures

    def __init__(self):
        self.futures_bridge = None

        #Working around circular dependencies. They can't be instanciated before SerialManager is, but SerialManager must be instanciated by the GUI to gve a COM port
        self.serial_manager = None #Will be set to SerialManager by shared reference after GUI's instanciation.
        self.serial_handshake_handler = None

        self.interface = None #Interface depends on Serial Manager, and can't be set before SerialManager is started with SerialManager.begin()

        self.action_loop_interval = 100 #Ms
        self.gui_queue_poll_interval = 100 #Ms
        self.futures_poll_interval = 100 #Ms

        #Links the name of the method called in a future (see FuturesBridge) and coroutine handlers. Normal methods can be handled locally.
        self.futures_method_handlers = { 
            "interface_main": self.handle_interface_main,
            "serial_shutdown": self.handle_serial_shutdown
        }

        self.asyncio_lock = threading.Lock()

        self.root = tk.Tk()
        self.root.title("Interface")
        self.root.geometry("400x300")
        self.gui_queue = queue.Queue() #Updates sent directly to GUI from elsewhere. Should really have been instanciated in the ProcessManager for more elegant code.

        self.begin_button = ttk.Button(self.root, text="Begin", command=self.on_start_setup)
        self.begin_button.pack(pady=10)

        self.serial_info = ttk.Label(self.root, text="Serial Communication Inactive")
        self.serial_info.pack(pady=20)

        self.ping_button = ttk.Button(self.root, text="Send Ping", command=self.send_ping)
        self.ping_button.pack(pady=10)

        self.status_label = ttk.Label(self.root, text="Status: Waiting for setup...")
        self.status_label.pack(pady=10)

        self.retry_button = ttk.Button(self.root, text="Retry Connection", command=self.retry_connection)
        self.retry_button.pack(pady=10)

        #Loop for any non-message actions that must be run periodicly
        self.root.after(self.action_loop_interval, self.action_loop) #tk.after works with tkinter GUIs, and starts the given method after timeout

        # Start the futures polling and GUI-queue update loops for real-time updates. 
        self.root.after(self.futures_poll_interval, self.poll_bridge)
        self.root.after(self.gui_queue_poll_interval, self.poll_gui_queue)

    def begin(self, futures_bridge, serial_manager, interface): #Called by the process manager, not from GUI.
        self.futures_bridge = futures_bridge
        
        self.serial_manager = serial_manager

        self.interface = interface

    def on_start_setup(self):
        """
        Procedure for setting up serial, and then starting Interface via it's start_main method. Gets the engines running.
        """

        try:
            asyncio.run_coroutine_threadsafe(self.interface.begin("COM3"), self.futures_bridge.loop)
            self.futures_bridge.schedule_coroutine(self.interface.main(), "interface_main") #Should be contained in Interface, I know, but like this I can keep track of returned futures all in one place.
        except Exception as e:
            raise

    def rename_com(self):
        # Schedule the setup_serial coroutine in the event loop
        try:
            self.serial_manager.set_port_name(give_me_a_port_from_gui_input_field)
        except Exception as e:
            #Update info to user messages
            pass

    def update_status_label(self, message):
        # Thread-safe update of the status label
        self.status_label.config(text=message)


    def action_loop(self):
        """
        Anything periodic not directly related to GUI info or handling of futures goes here
        """
        pass


    def poll_bridge(self):
        """
        Polls for the futures.done and futures.result from the futures bridge, and runs the correct handler for the async coroutine completed.
        """

        futures_metadata = self.bridge.poll_futures()
        for method_name, params, return_data, exception in futures_metadata:
            #Gets and runs correct handler
            try:
                handler = self.futures_method_handlers[method_name] #Gets the method based on method_name
            except KeyError:
                print(f"{method_name} has no handler")
            handler(method_name, params, return_data, exception) #method_name and params info gives flexibility, though rarely used. Remove from GUI and FuturesBridge?

        self.master.after(self.futures_poll_interval, self.poll_bridge)

    def poll_gui_queue(self):
        """
        Polls for updates to the GUI queue, directly from anywhere that has access to self.gui_queue
        """
        try:
            while True:
                with self.asyncio_lock:
                    self.queue_message = self.gui_queue.get_nowait()
                    if "serial_error" in self.queue_message:
                        print(f"Serial error: {self.queue_message}")
                    elif "serial_status" in self.queue_message:
                        print(f"Serial status: {self.queue_message}")
        except queue.Empty:
            pass
        self.root.after(self.gui_queue_poll_interval, self.poll_gui_queue)

    def run(self):
        self.root.mainloop()


use_gui = False

if __name__ == "__main__": #If program not started from another application...
    # use GUI
    use_gui = True

process_manager = ProcessManager(use_gui)
process_manager.startup()

# if __name__ == "__main__":
# main()

# import tkinter as tk
# from queue import Queue
# import threading
# import time
# import json

# # Worker function to simulate background processing
# def worker(queue):
# for i in range(5):
# # Example data to send (dictionary)
# data = {"id": i, "status": "processing", "value": i * 30}
# queue.put(data) # Send dictionary to the queue
# time.sleep(1) # Simulate processing time
# # Sending a final message
# queue.put({"id": None, "status": "done"})

# # Function to update the GUI
# def update_gui():
# try:
# while not queue.empty():
# data = queue.get_nowait()
# id_text = f"Received: {data['id']}"
# id.config(text=id_text)
# status_text = f"Received: {data['status']}"
# status.config(text=status_text)
# value_text = f"Received: {data['value']}"
# value.config(text=value_text)
# except Exception as e:
# print(f"Error: {e}")
# finally:
# root.after(100, update_gui) # Schedule next check

# # Setup tkinter GUI
# root = tk.Tk()
# root.title("GUI Queue Example")

# id = tk.Label(root, text="Waiting for data...", font=("Arial", 14))
# id.pack(pady=20)
# status = tk.Label(root, text="Waiting for data...", font=("Arial", 14))
# status.pack(pady=20)
# value = tk.Label(root, text="Waiting for data...", font=("Arial", 14))
# value.pack(pady=20)

# queue = Queue() # Thread-safe queue

# # Start worker thread
# thread = threading.Thread(target=worker, args=(queue,))
# thread.daemon = True # Exit thread when main program exits
# thread.start()

# # Start GUI queue polling
# root.after(100, update_gui)

# # Start the tkinter main loop
# root.mainloop()
