CyrusAlexanderBarrett-Hammer/Programmable-furnace/main/09-singleton_instances.ino

SerialMessageHandler &serialMessageHandler = SerialMessageHandler::getInstance();
SerialConnectionManager &serialConnectionManager = SerialConnectionManager::getInstance();
SerialHandshakeHandler &serialHandshakeHandler = SerialHandshakeHandler::getInstance();
