CyrusAlexanderBarrett-Hammer/Programmable-furnace/(commit log)

2025-01-17 Missing only the interface class, the GUI, and some process management fixes.
    [interface.py]
2025-01-20 Added a timer class and message timers Arduino-side. Fixed some bugs.
    I will get the async interfaced with the synchronous main thread in Python when Arduino program is done.
2025-01-20 Added a thermosensor recovery and alarm trigger if failed Arduino-side.
2025-01-22 Completed Arduino code.
2025-01-29 Did renaming and minor bugfixes. Worked on documentation.
    [interface.py]
2025-01-31 Added flowcharts and schematics for the watchdog module.
2025-02-02 Always...a...bug! Also, cleared up an uneccessary parameter.
    [interface.py]
2025-02-11 Modularized Arduino program. Slight updates to documentation.
